DroneTales/SmartRfSwitch/3d models/RfSwitchTopCase.stl

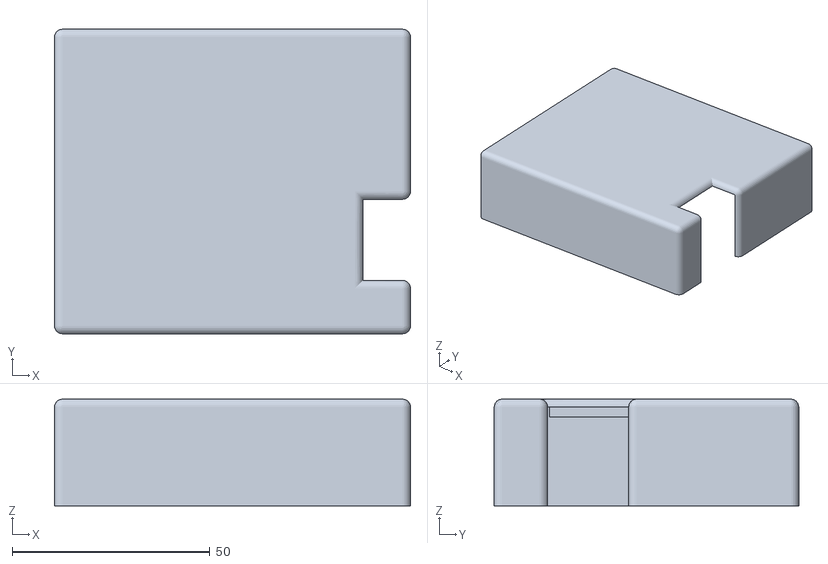
[picture p1: CAD file, 2025-05-24]
3d models/RfSwitchTopCase.stl
90.0 x 77.0 x 27.0
