DroneTales/SmartRfSwitch/3d models/RfSwitchCase.stl

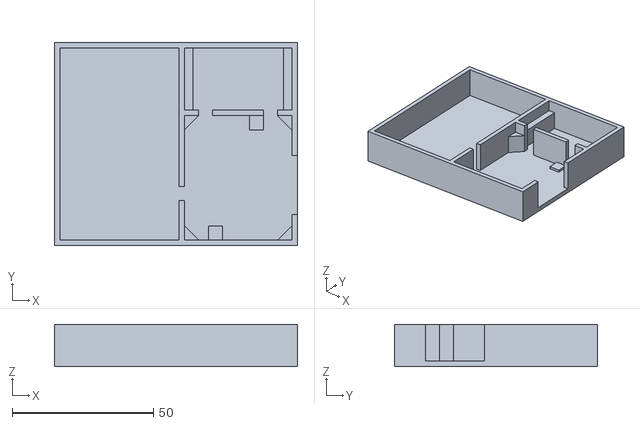
[picture p2: CAD file, 2025-05-24]
3d models/RfSwitchCase.stl
86.0 x 72.0 x 15.0
