DroneTales/SmartRfSwitch/(list of files, drawings)

Other design files:
wiring/SmartRfSwitch.fzz
