DroneTales/SmartRfSwitch/wiring/SmartRfSwitchWiring.png

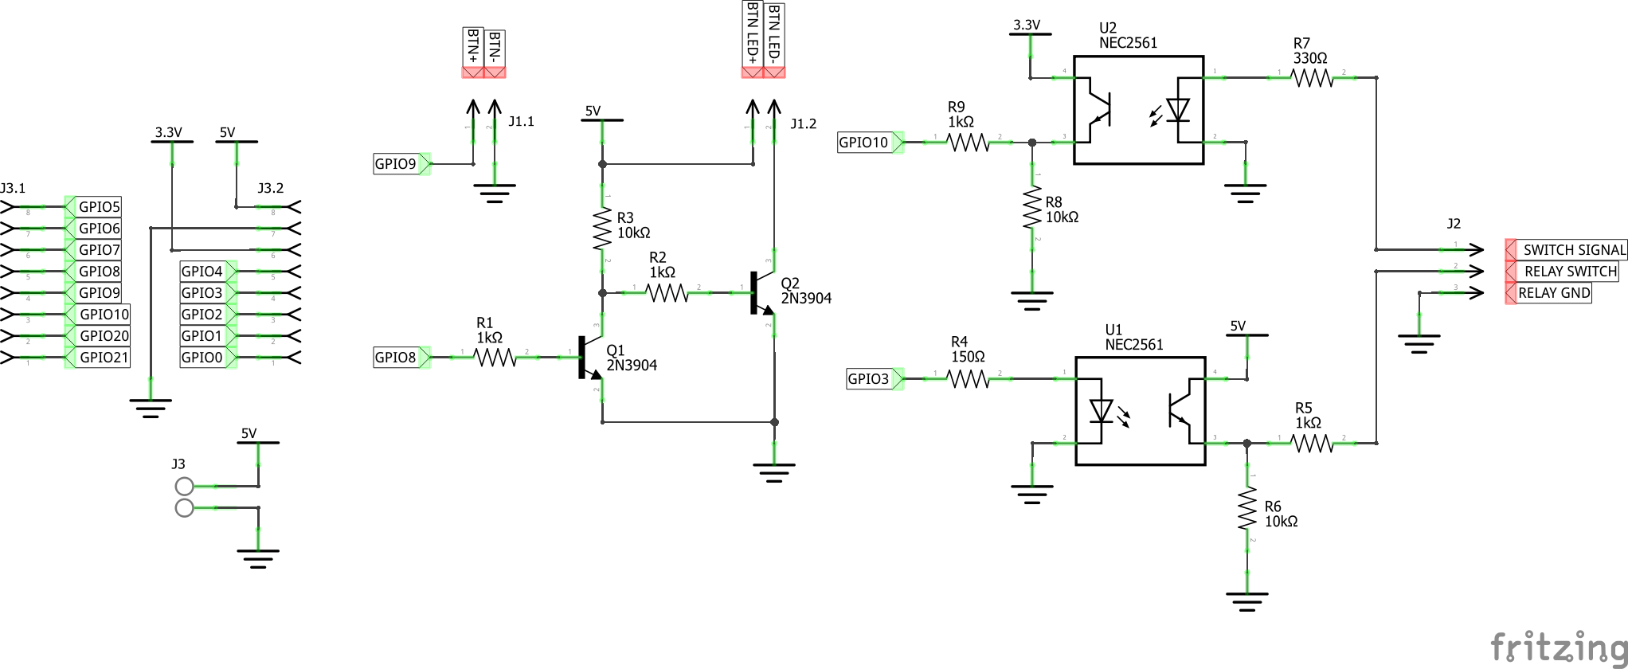
wiring/SmartRfSwitchWiring.png
